e71828/Spur-gear-reducer/机械设计课程设计.pdf

## 机械设计课程设计 计算说明书

设计题目 | 带式输送机传动装置 4−E
班 | 级
学 | 号
姓 | 名
专 | 业 机械设计制造及其自动化

指导老师

完成日期 | 2018 年 07 月 06 日

目 录

1. 设计任务

传动简图如图 1 所示，设计参数列表列于表 1，工作条件：连续单向运

转，工作时有轻微振动，使用期 10 年，每年 300 个工作日，小批量生

产，两班制工作，输送机的工作轴转速允许误差为±5%，带式输送机的传

动效率为 0.96。

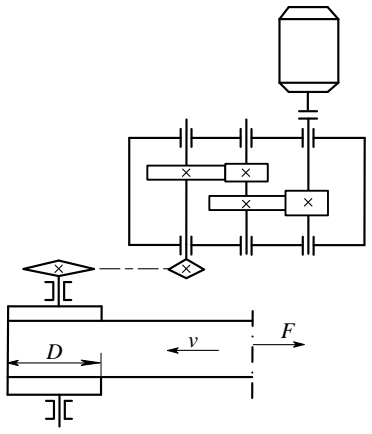
[picture p1: figure]

图 1 带式输送机传动简图

表 1 带式输送机的设计参数

题号 | 4−A | 4−B | 4−C | 4−D | 4−E
输送带的牵引力 F/kN | 2.8 | 2.9 | 3.0 | 3.2 | 3.6
输送带的速度 v/(m/s) | 0.9 | 0.85 | 1.0 | 0.95 | 0.75
输送带滚筒的直径 D/mm | 450 | 420 | 480 | 440 | 400

2. 传动方案拟定和分析

图 1 所给定的传动方案中利用了二级展开式齿轮减速器和链传动，我们

来分析它所具备的优点和缺点。

链传动和齿轮传动的效率都很高，结构紧凑，这两个的组合也保证了平

均传动比的恒定。齿轮传动利用了二级展开式齿轮减速箱，闭式传动，传动

比大，尺寸小，工作可靠，维护良好寿命可达到一二十年。直齿轮相比斜齿

轮，可以通过变位来提高强度和平稳性，或配凑中心距，成本比斜齿轮低；

直齿轮的理论上是没有轴向力的，可以采用深沟球轴承，有利于提高寿命和

维修与更换，设计起来也比较简单。

链传动的平均传动比不恒定，虽然链传动可以在恶劣环境中工作，但是

在工作中加重了振动和冲击。齿轮传动的最大要求就是安装精度，这又提升

了成本。斜齿轮的传动平稳性要优于直齿轮，而且同样配合链传动，斜齿轮

还能缓冲部分冲击，有利于提高寿命。

3. 传动系统动力参数计算

## 根据题目 4−E 要求，F=3.6kN，v=0.75m/s，D=400mm，结合传动方案，

选用深沟球轴承，每对轴承的效率 η=0.99，直齿轮采用 7 级精度，每对齿

轮副的效率 η=0.98，采用滚子链，滚子链的效率 η=0.96，联轴器由于需要

与电机直接连接，采用弹性套柱销联轴器，效率 η=0.99，已知输送带的效率

为 0.96。根据计算，所需要的电机功率为
( | ) ( | )
2
d = | × | ÷ | × | × | × | × | × | × | = 0.3 0.75 0.96 0.99 0.96 0.98 0.99 0.99 0.99 3.208 | | kW | P | ，

要求电动机提供的额定功率 Pm≥Pd，初步选用同步转速 1500 r/min 的三相异

步电机 Y112M−S，额定功率 4 kW，满载转速 1440 r/min，由于工作及转速
w n | vD = | × | × ÷× = 2 / | 1000 60 (2 ) 35.8 r/min π | ，可以算得传动系统的总传动比
为 | m | w in n = | = | = / | 1440 / 35.8 40.223，初选滚子链的传动比为 c

### i = 2.25，由于电

机轴到轴 I 的传动比为 1，则可以算得二级齿轮减速器的减速比为
g | c i ii = | = / | 40.223 / 2.25 17.8769 = | ，取高速级齿轮副传动比 1 | c i | i = | = 1.35 4.91，

由于各轴的转速和输入功率都能分别通过传动比和效率确定下来，

T | P | n | Pn = | π | ≈ 1000 / (2 / 60) 9549 / ，从而输入转矩也都可以确定下来，得表 2。

表 2 传动基本参数表

| 电动机轴 | 轴 I | 轴 II | 轴 III | 滚筒轴
功率 P/kW | 4 | 3.9204 | 3.8036 | 3.6902 | 3.5072
转速 n/(r/min) | 1440 | 1440 | 293.28 | 80.55 | 35.8
转矩 T/(N∙m) | 26.526 | 25.998 | 123.486 | 437.481 | 935.508
传动比 i | 1 | 4.91 | 3.64 | 2.25
效率 η | 0.9801 | 0.9702 | 0.9702 | 0.9504

4. 传动零件的设计

4.1 链传动的设计

计算项目及内容 | 主要结果
1. 选择链轮齿数

取小链轮齿数 z1=21，大链轮齿数 2 z =× = 21 2.25 47.25，
取 z2=47。
2. 确定计算功率

由参考文献[1]表 9-6，查得工况系数 KA=1.1，由图 9-

13，查得主动链轮齿数系数 Kz=1.22，采用双排链，多排链

系数 Kp=1.75，计算功率

ca | A | p
P K KP K = | =× | × | = z | / | 1.1 1.22 3.6902 /1.75 2.83 kN
3. 选择链条型号

## 由 Pca=2.83 kW，n1=293.8 r/min，和 Pca≤Pc，查图 9-11，

## 选择 16A-2，节距 p=25.4 mm。

4. 计算链节数和中心距

## 中心距 a0=(30~50)p=762~1270 mm，取 a0=1000 mm，

相应的链节数为

2
0 | 1 | 2 | 1 | 2
p0
0
2

2
2 | 2
2 1000 21 47 21 47 | 25.4 113.18
25.4 | 2 | 2 | 1000
+ | − | = | + | + | | π
× | + | − | = | + | + | × | = | | π
a zz | zz | p L
p | a

取 p0 L =114 (偶数)，查表 9-8，中心距计算系数

小链轮 z1=21，

大链轮 z2=47

## 链号 16A-2

1

0.24869 0.24809 114 21 0.24849 | 3.4 0.24866
3..6 3.4 | 47 21
− | − | = | + | × | − | = | − | − | f

则链传动的最大中心矩
( | )
( | )
max | 1 | p | 1 | 2 2
0.24866 25.4 2 114 21 47 | 1010.55 mm
= | − | + | |
= | × | ×× | − | + | = | |
a | fp L | z z
5. 计算链速 v，确定润滑方式
11 v nzp = | = | ×× | = / 60000 80.55 21 25.4 / 60000 0.72 m/s

## 由v = 0.72 m/s，链号 16A-2，查表 9-14，采用滴油润滑。

6. 计算水平布置时的压轴力 Fp
有效圆周力 e F | Pv = | = | × | = 1000 / 1000 3.6902 / 0.72 5152 N，

链轮水平布置时压轴力系数 KFp=1.15，则压轴力为

p | pe
F KF = | = | × | = F | 1.15 5125 5894 N
7. 选择链轮材料，计算尺寸

由表 9-5，选择 40 钢，并淬火、回火处理。

小链轮分度圆直径

1

1

25.4 | 170.421 mm
180 | 180
sin | sin
21
= | = | = | | | ° | °

p d

z

大链轮分度圆直径

2

2

25.4 | 380.281 mm
180 | 180
sin | sin
47
= | = | = | | | ° | °

p d

z

最大中心距
1011 mm

滴油润滑

压轴力

p

F = 5894 N

大链轮分度
圆 d2=380.281
mm

4.2 高速级齿轮副的设计

计算项目及内容 | 主要结果
1. 选择齿数类型、材料，初选齿轮齿数

直齿圆柱齿轮，压力角 α=20°，齿顶高系数 ha
*

=1，顶

隙系数 c*

=0.25，7 级精度，小齿轮采用 40Cr 合金（调质），

齿面硬度 280 HBS，大齿轮采用 45 钢（调质），齿面硬度

240 HBS，两个齿轮都是软齿面。

初选小齿轮齿数 z1=20，大齿轮 2 z =× = 20 4.91 98.2，取
z2=98。
2. 按齿面接触疲劳强度设计
(1) 小齿轮分度圆直径计算公式
3 | 2
Ht 1 | H E
1t
d | H
2 | 1 []
ε
φ | σ
+ | ≥ | ⋅ | ⋅ | |
KT u | ZZZ d
u
1) 确定公式中的各参数值

① 试选载荷系数 Ht K =1.5。

### ② 小齿轮传递的转矩 1 T = ⋅ 25998 N mm 。

③ 由表 10-7 试选宽径比 d φ =1。

④ 由图 10-20 查得区域系数 H Z = 2.5。

⑤ 由表 10-5 查得材料的弹性影响系数 | 1/2

## E Z =189.8 MPa 。

⑥ 计算接触疲劳强度用重合度系数Zε。

*

1 | 1 | 1 arccos[ cos / ( | 2 )]

### arccos[20 cos20 / (20 2 1)] 31.3213

α | α = | +
= | × | ° | +× = | °
a | a z | z | h

标准直齿轮

## 小齿轮 40Cr

大齿轮 45 钢

初选齿数
z1=20，z2=98

*
2 | 2 | 2
1 | 1 | 2 | 2

E

## arccos[ cos / ( 2 )] arccos[98 cos20 / (98 2 1)] 22.9422

[ (tan | tan ) | (tan | tan )] / (2 )

## [20 (tan31.3213 tan 20 ) 98 (tan 22.9422 tan 20 )] / (2 ) 1.7035

4 41
3

α

α

α | | α
ε | α | α | α | α

ε

= | | +
= | × | ° | +× = | °
= | − | + | − | π
= | × | °− | ° +
× | °− | ° | π =
− | − = | =
a | a
a | a
z | z | h
z | 'z | '
Z | .7035 0.8749
| 3 | =

⑦ 计算接触疲劳许用应力 H [] σ 。

由图 10-25d 查得小齿轮和大齿轮的接触疲劳强度极限

### 分别为 Hlim1 σ = 550 MPa ， Hlim2 σ = 600 MPa 。

计算应力循环次数：

9
1 | 1
9 | 8
2 | 1
60 | 60 1440 1 (2 8 300 10) 4.1472 10
/ | 4.1472 10 / 4.91 8.4464 10
= | = × | ×× × × | × | = | ×
= | = | × | = | ×
N | n jLh

### N Nu

由图 10-23，查得接触疲劳寿命系数 H 1
= 0.90 K N 、

H 2

= 0.95 K N 。

取失效概率为 1%，安全系数为 S=1，得

1

2

H Hlim1
H 1

H Hlim2
H2
0.90 550 [ ] | 495 MPa
1
0.95 600 [ ] | 570 MPa
1

σ
σ
σ
σ
× = | = | =
× = | = | =

N

N

K
S
K
S
取 H 1 [] σ 和 H2 [] σ 中的较小者作为该齿轮副的接触疲劳许用应
力，即[ ] min [ ] ,[ ] | 495 MPa σ | σσ H = | { H1 | H2} = | 。
2) 试算小齿轮分度圆直径
3 | | | | 2
Ht 1 | H E
1t
d | H
3 | 2
2 | 1
[]
2 1.5 25998 4.91 1 2.5 189.8 0.8749 1 | 4.91 | 495

ε
φ | σ
+ | ≥ | ⋅ | ⋅ | |
×× | + | × | × | = | × | × | |
KT u | ZZZ d
u

重合度
εα=1.7035

接触疲劳许用

应力

## [σH]=495MPa

=40.4187 mm
(2) 调整小齿轮分度圆直径
1) 计算实际载荷系数前的数据准备

① 圆周速度 v。
1t 1 v | dn =π | =π× | × / 60000 | 40.4187 1440 / 60000 3.05 m/s =

② 齿宽 b。
d 1t b | d = | =× | = φ | 1 40.4187 40.4187 mm
2) 计算实际载荷系数KH

① 由表 10-2，查得使用系数 A K =1.25。

② 根据v = 3.05 m/s，7 级精度，由图 10-8，查得动载系数
v K =1.12。

③ 齿轮的圆周力。
t1 | 1 | 1t F | Td = | = 2 / | 2 25998 / 40.4187 1286 N × | =
A t1 KF b/ | 1.25 1286 / 40.4187 39.8 N/mm<100 N/mm = | × | =
查表 10-3 得齿间载荷分配系数 H | 1.2 K α = | 。

④ 由表 10-4 用插值法查得 7 级精度、小齿轮相对支撑非对

称布置时，齿向载荷分布系数 H | 1.417 K β = | 。

由此可以得到实际载荷系数系数
H | A | vH | H | 1.25 1.12 1.2 1.417 2.3806 K KKK K = | = | × | ×× | = α | β
3) 按实际载荷系数算得的分度圆直径
3 | 3
H
1 1t
Ht
2.3806 40.4187 | 47.146 mm
1.5
= | = | × | =

## K dd

K

及相应的齿轮模数

试算直径

## d1=40.419 mm

调整后的直径

## d1=47.146 mm

对应模数

## m=2.357 mm

1 | 1 mdz = | = | = / | 47.146 / 20 2.357 mm
3. 按齿根弯曲疲劳强度设计
(1) 模数计算公式

3
Ft 1 | Fa sa
t | 2
d1 | F

2
[]

ε
φ | σ
- | ≥ | ⋅ | |

### K TY Y Y

m
z
1) 确定公式中的各参数值

### ① 试选KFt =1.5。

② 计算弯曲疲劳强度用重合度系数。
0.75 | 0.75 0.25 | 0.25 | 0.6903
1.7035 ε
α ε
Y = | + | = | + | =

③ 计算 Fa sa
F [] σ

YY 。

由图 10-17 查得齿形系数 Fa1 Y = 2.82、 Fa 2 Y = 2.19。

由图 10-18 查得应力修正系数 sa1 Y =1.55、 sa 2 Y =1.81。

由图 10-24 查得小齿轮和大齿轮的弯曲疲劳强度极限分别

### 为σ Flim1 = 500 MPa 、 Flim2 σ = 380 MPa。

由图 10-22 查得弯曲疲劳寿命系数 F 1
K N = 0.85 、

F 2

K N = 0.88。

取弯曲疲劳安全系数 S=1.4，得

1

2

F Flim1
F1

F Flim2
F2
0.85 500 [ ] | 303.57 MPa
1.4
0.88 380 [ ] | 238.86 MPa
1.4

σ
σ
σ
σ
× = | = | =
× = | = | =

N

N

K
S
K
S

弯曲疲劳许用

应力

## [σF]1=303 MPa

## [σF]2=238 MPa

Fa1 sa1

F1

Fa 2 sa 2

F2

2.82 1.55 0.0144
[ ] | 303.57
| 2.19 1.81 0.0166
[ ] | 238.86

σ

σ

× = | =
× = | =

Y Y

YY

因为大齿轮的 Fa sa
F [] σ

YY 大于小齿轮，所以取

Fa sa | Fa 2 sa 2
F | F2

0.0166

[] [] σ | σ = | = YY Y Y
2) 试算齿轮模数

3
Ft 1 | Fa sa
t | 2
d1 | F
3

2

2
[]
2 1.5 25998 0.6903
= | 0.0166
1 20
=1.3073 mm

ε
φ | σ
- | ≥ | ⋅ | |
×× | ×
×
×

### K TY Y Y

m
z
(2) 调整齿轮模数
1) 计算实际载荷系数前的数据准备

① 圆周速度 v。
1 | t1 d mz = | = | ×= 1.3073 20 26.146 mm
11 v | dn =π | =π× | × / 60000 | 26.146 1440 / 60000 1.97 m/s =

② 齿宽 b。
d1 b | d = | =× | = φ | 1 26.146 26.146 mm

③ 宽高比 b/h。
( | ) * | *
a | t h | h cm = | + | = ×+ | × | = (2 | ) | 2 1 0.25 1.3072 3.0831 mm
b h/ | 26.146 / 3.0831 8.48 = | =
2) 计算实际载荷系数

试算模数

## m=1.3073 mm

① 根据v =1.97 m/s，7 级精度，由图 10-8，查得动载系数
Kv =1.078。

② 齿轮的圆周力。
t1 | 1 | 1t F | Td = | = 2 / | 2 25998 / 26.146 1989 N × | =
A t1 KF b/ | 1.25 1989 / 26.146 95 N/mm<100 N/mm = | × | =
③ 查表 10-3 得齿间载荷分配系数 F | 1.2 K α = | 。
④ 由表 10-4 用插值法查得 H | 1.417 K β = | ，结合b h/ | 8.48 = | ，
查图 10-13，得 F | 1.35 K β = | 。

则实际载荷系数
F | A | vF | F | 1.25 1.078 1.2 1.35 2.1830 K KKK K = | = | × | ×× | = α | β
3) 按实际载荷系数算得的模数

3 3
F
t
Ft
2.1830 1.3073 | 1.4815 mm
1.5
= | = | × | =

K
m m
K

对比计算结果，由齿面接触疲劳强度计算的模数 m 大

于由齿根弯曲疲劳极限计算的模数，由于齿轮模数的大小

主要取决于弯曲疲劳强度所决定的承载能力，而齿面接触

疲劳强度所决定的承载能力，仅与齿轮直径有关，可取由弯

曲疲劳强度算的的模数 1.4815 mm，但考虑到动力传动的可

靠性，一般模数不小于 2 mm，所以就近取标准值 m=2 mm，

按接触疲劳强度算的分度圆直径d1 = 47.146 mm，算得小齿
轮齿数 1 | 1 z dm = | = | = / | 47.146 / 2 23.573。

调整后的模数

## m=1.4815 mm

小于最小可靠

传动标准 m=2
mm

故取模数为

## m=2 mm

取 1z = 24，则大齿轮齿数 2 | 1 z uz = | = | ×= 4.91 24 117.84，取

2 z =119， 1z 与 2 z 互为质数。这样设计出的齿轮既满足齿面

接触疲劳强度，又满足了齿根弯曲疲劳强度，并做到结构紧

凑，磨损均匀，避免浪费。

4. 几何尺寸计算
(1) 计算分度圆直径
1 | 1
2 | 2

2 24 48 mm
2 119 238 mm
= | =× =
= | =× | =

### d mz d mz

(2) 计算中心距
1 | 2 add = | + | = | + | = ( | ) / 2 (48 238) / 2 143 mm
(3) 计算齿轮宽度
d1 b | d = | =× = φ | 1 48 48 mm

考虑不可避免的安装误差，为了保证设计齿宽和节省

材料，一般将小齿轮略加宽(5~10) mm，即
1 bb =+ | = + | = (5 ~ 10) 48 (5 ~ 10) 53 ~ 58 mm

取 1 b = 55 mm ，而使大齿轮的齿宽等于设计齿宽，即

### 2 bb = = 48 mm 。

5. 圆整中心距后的强度校核

上述齿轮副的中心距不便于相关零件的设计和制造。

为此，可以通过调整传动比、改变齿数或变位法来进行圆

整。本设计采用变位法将中心距就近圆整至a' =145 mm，以

变位系数和不超过图 10-21a 推荐的合理工作范围为宜。其

它几何参数，如 z1、z2、m、α、b 等保持不变。

z1=24，z2=119

中心距

## a=143 mm

小齿轮齿宽

## b1=55 mm

大齿轮齿宽

## b2=48 mm

圆整中心距

## a' =145 mm

(1) 计算变位系数和
1) 计算啮合角、齿数和、变位系数和、中心距变动系数，

齿顶高降低系数。

1 | 2
1 | 2

## arccos[( cos ) / ] arccos[(143 cos20 ) /145] 22.0691

24 119 143

## (inv inv ) / (2tan ) =(inv22.0691 inv20 ) 143 / (2tan 20 ) 1.050

α | α
α | α | α

∑

∑ | ∑

=
= | × | ° | = | °
=+ = + | =
=+ = | −
°− | ° × | ° =
' | a | a'

### z zz

x xx | ' | z
( | ) / | (145 143) / 2 1
1.050 1 0.050 ∑
= | − | = | − | =
∆= − = | −=
y | a' a m

### yx y

从图 10-21a 知，当前的变位系数提高了齿轮强度，但

重合度有所降低。

2) 分配变位系数
由图 10-21b 可知，坐标点( / 2, / 2) (71.5,0.525) z | x ∑ | ∑ | = | 位

于 L14 线与 L15 线之间，按这两条线作射线，再从横坐标

的 z1、z2处作垂直线，与射线交点的纵坐标分别为 1 x = 0.52、

2 x = 0.53。

(2) 齿面接触疲劳强度校核
1) 校核公式

H1
H | 3 | HE
| d1
2 | 1
σ | ε φ
+ = | ⋅ | ⋅ KT u | ZZZ
d | u
2) 数据准备

① 圆周速度 v。
11 v | dn =π | =π× × / 60000 | 48 1440 / 60000 3.62 m/s =

② 接触齿宽b = 48 mm 。

啮合角
α' = ° 22.0691

变位系数和+

正传动

变位系数
1 x = 0.52
2 x = 0.53

## ③ 传动比u = = 119 / 24 4.9583。

3) 计算实际载荷系数KH

① 根据v = 3.62 m/s，7 级精度，由图 10-8，查得动载系数
v K =1.14。

② 齿轮的圆周力（用分度圆估算）。
t1 | 1 | 1 F | Td = | =× | = 2 / | 2 25998 / 48 1083 N
A t1 KF b/ | 1.25 1083 / 48 28 N/mm<100 N/mm = | × | =
查表 10-3 得齿间载荷分配系数 H | 1.2 K α = | 。

③ 由表 10-4 用插值法查得 7 级精度、小齿轮相对支撑非对

称布置时，齿向载荷分布系数

H

1.426 1.417 1.417 | (48 40) 1.4188 80 40 β
− = | + | × | − | = − K

由此可以得到实际载荷系数系数
H | A | vH | H | 1.25 1.14 1.2 1.4188 2.4261 K KKK K = | = | × | ×× | = α | β
4) 计算区域系数ZH。
H | 2 | 2
2cos | 2 cos22.0691 | 2.3636
cos sin | cos 20 sin 22.0691

α
αα
× | ° = | = | = °× | °
' Z | '
5) 计算接触疲劳强度用重合度系数Zε。

*
1 | 1 | 1 | 1

*
2 | 2 | 2 | 2
1 | 1
arccos[ cos / ( | 2 | )]

## arccos[24 cos20 / (24 2 1 0.52 0.05)]

33.1604
arccos[ cos / ( | 2 | )]

## arccos[119 cos20 / (119 2 1 0.53 0.05)]

23.5250
[ (tan | tan α
α | α
α | α
ε | α
= | | + | + −∆
= | × | ° | + ×+ | −
= | °
= | | + | + −∆
= | × | ° | + ×+ | −
= | °
= | −
a | a
a | a

a

z | z | hx | y
z | z | hx | y
z | 2 | 2 ) | (tan | tan )] / (2 )

## [20 (tan33.1604 tan 22.0691 )

α | α | α + | − | π
= | × | °− | ° +
a 'z | '

节圆
1 d' = 45.6173
2 d' = 241.3287

齿顶圆
1 = 53.880 a d'
2 = 243.920 a d'

齿根圆
f1 d = 45.080
f2 d = 235.120

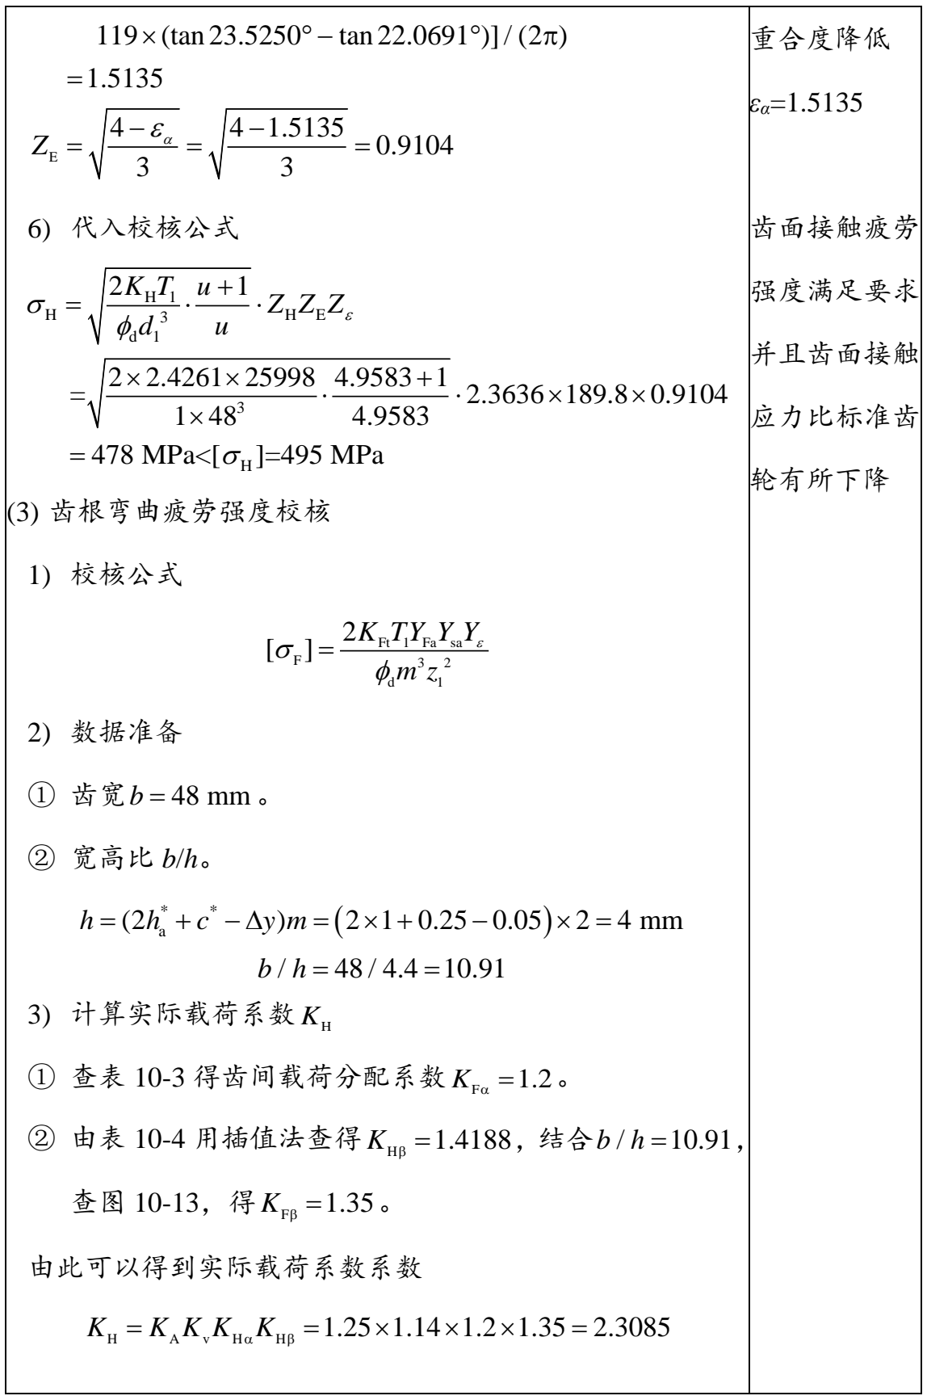
[picture p2: figure]
119 (tan 23.5250 tan 22.0691 )] / (2 ) 1.5135; 6) 代入校核公式; 478 MPa<[ ]=495 MPa; ZZZ; (3) 齿根弯曲疲劳强度校核; 1) 校核公式; 2) 数据准备; ① 齿宽b = 48 mm 。; ② 宽高比 b/h。; 3) 计算实际载荷系数KH; ① 查表 10-3 得齿间载荷分配系数 F; 由此可以得到实际载荷系数系数; 重合度降低; 齿面接触疲劳; 强度满足要求; 并且齿面接触; 应力比标准齿; 轮有所下降

a h | h c | ym = | + −∆ | = × + | − | × = (2 | ) | 2 1 0.25 0.05 2 4 mm
② 由表 10-4 用插值法查得 H | 1.4188 K β = | ，结合b h/ 10.91 = | ，
H | A | vH | H | 1.25 1.14 1.2 1.35 2.3085 K KKK K = | = | × | ×× | = α | β

4) 弯曲疲劳强度用重合度系数 | 0.75 0.25 | 0.7455
1.5135
Yε = | + | = | 。
5) 由图 10-17 查得齿形系数 Fa1 Y = 2.16、 Fa 2 Y = 2.07。
6) 由图 10-18 查得应力修正系数 sa1 Y =1.825、 sa 2 Y =1.93。
7) 代入校核公式

Ft 1 Fa1 sa1
F1 | 32
d | 1
3 | 2

F1

Ft 1 Fa 2 sa 2
F2 | 32
d | 1
3 | 2

2

2 2.3085 25998 2.16 1.825 0.7455 1 2 24

## 76.55 MPa<[ ] 303.57 MPa

2

2 2.3085 25998 2.07 1.93 0.7455 1 2 24

## 77.58 MPa

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
× | × | × | × | × = | ××
= | =

=

× | × | × | × | × = | ××

=

### K TY Y Y

mz

### K TY Y Y

mz

## <[ ] 238.86 MPa σ F2 =

齿根弯曲强度

满足要求，并

且小齿轮的抵

抗弯曲疲劳破

坏的能力大于

大齿轮。

4.3 低速级齿轮副的设计

计算项目及内容 | 主要结果
1. 选择齿数类型、材料，初选齿轮齿数

直齿圆柱齿轮，压力角 α=20°，齿顶高系数 ha
*

=1，顶

隙系数 c*

=0.25，7 级精度，小齿轮采用 40Cr 合金（调质），

齿面硬度 280 HBS，大齿轮采用 45 钢（调质），齿面硬度

240 HBS，两个齿轮都是软齿面。

初选小齿轮齿数 z1=20，大齿轮 2 z =× = 20 3.64 72.8，取
z2=73。
2. 按齿面接触疲劳强度设计
(1) 小齿轮分度圆直径计算公式
3 | 2
Ht 1 | H E
1t
d | H
2 | 1 []
ε
φ | σ
+ | ≥ | ⋅ | ⋅ | |
KT u | ZZZ d
u
1) 确定公式中的各参数值

① 试选载荷系数 Ht K =1.5。
② 小齿轮传递的转矩 1 T = | ⋅ 123846 N mm。

③ 由表 10-7 试选宽径比 d φ =1。

④ 由图 10-20 查得区域系数 H Z = 2.5。

⑤ 由表 10-5 查得材料的弹性影响系数 | 1/2

## E Z =189.8 MPa 。

⑥ 计算接触疲劳强度用重合度系数Zε。

*

1 | 1 | 1 arccos[ cos / ( | 2 )]

### arccos[20 cos20 / (20 2 1)] 31.3213

α | α = | +
= | × | ° | +× = | °
a | a z | z | h

标准直齿轮

## 小齿轮 40Cr

大齿轮 45 钢

初选齿数
z1=20，z2=73

*
2 | 2 | 2
1 | 1 | 2 | 2

E

## arccos[ cos / ( 2 )] arccos[73 cos20 / (73 2 1)] 23.8462

[ (tan | tan ) | (tan | tan )] / (2 )

## [20 (tan31.3213 tan 20 ) 73 (tan 23.8462 tan 20 )] / (2 ) 1.6852

4 41
3

α

α

α | | α
ε | α | α | α | α

ε

= | | +
= | × | ° | +× = | °
= | − | + | − | π
= | × | °− | ° +
× | °− | ° | π =
− | − = | =
a | a
a | a
z | z | h
z | 'z | '
Z | .6852 0.8784
| 3 | =

⑦ 计算接触疲劳许用应力 H [] σ 。

由图 10-25d 查得小齿轮和大齿轮的接触疲劳强度极限

### 分别为 Hlim1 σ = 550 MPa ， Hlim2 σ = 600 MPa 。

计算应力循环次数：

8
1 | 1
8 | 8
2 | 1
60 | 60 293.28 1 (2 8 300 10) 8.4464 10
/ | 8.4464 10 / 3.64 2.3204 10
= | = × | ×× × × | × | = | ×
= | = | × | = | ×
N | n jLh

### N Nu

由图 10-23，查得接触疲劳寿命系数 H 1
= 0.90 K N 、

H 2

= 0.95 K N 。

取失效概率为 1%，安全系数为 S=1，得

1

2

H Hlim1
H 1

H Hlim2
H2
0.90 550 [ ] | 495 MPa
1
0.95 600 [ ] | 570 MPa
1

σ
σ
σ
σ
× = | = | =
× = | = | =

N

N

K
S
K
S
取 H 1 [] σ 和 H2 [] σ 中的较小者作为该齿轮副的接触疲劳许用应
力，即[ ] min [ ] ,[ ] | 495 MPa σ | σσ H = | { H1 | H2} = | 。
2) 试算小齿轮分度圆直径
3 | | | | 2
Ht 1 | H E
1t
d | H
3 | 2
2 | 1
[]
2 1.5 123846 3.64 1 2.5 189.8 0.8784 1 | 3.64 | 495

ε
φ | σ
+ | ≥ | ⋅ | ⋅ | |
×× | + | × | × | = | × | × | |
KT u | ZZZ d
u

重合度
εα=1.6852

接触疲劳许用

应力

## [σH]=495MPa

试算直径

## d1=69.506 mm

=69.5060 mm
(2) 调整小齿轮分度圆直径
1) 计算实际载荷系数前的数据准备

① 圆周速度 v。
1t 1 v | dn =π | =π× | × / 60000 | 69.5060 293.28 / 60000 1.07 m/s =

② 齿宽 b。
d 1t b | d = | =× | = φ | 1 69.5060 69.5060 mm
2) 计算实际载荷系数KH

① 由表 10-2，查得使用系数 A K =1.25。

② 根据v =1.07 m/s，7 级精度，由图 10-8，查得动载系数
v K =1.043。

③ 齿轮的圆周力。
t1 | 1 | 1t F | Td = | = 2 / | 2 123846 / 69.5060 3564 N × | =
A t1 KF b/ | 1.25 3564 / 69.5060 64 N/mm<100 N/mm = | × | =
查表 10-3 得齿间载荷分配系数 H | 1.2 K α = | 。

④ 由表 10-4 用插值法查得 7 级精度、小齿轮相对支撑非对

称布置时，齿向载荷分布系数

H

1.426 1.417 1.417 | (69.5060 40) 1.4216 80 40 β
− = | + | × | − | = − K

由此可以得到实际载荷系数系数
H | A | vH | H | 1.25 1.043 1.2 1.4216 2.2241 K KKK K = | = | × | ×× | = α | β
3) 按实际载荷系数算得的分度圆直径
3 | 3
H
1 1t
Ht
2.2241 69.5060 | 79.258 mm
1.5
= | = | × | =

## K dd

K

调整后的直径

## d1=79.258 mm

对应模数

## m=3.963 mm

及相应的齿轮模数
1 | 1 mdz = | = | = / | 79.258 / 20 3.963 mm
3. 按齿根弯曲疲劳强度设计
(1) 模数计算公式

3
Ft 1 | Fa sa
t | 2
d1 | F

2
[]

ε
φ | σ
- | ≥ | ⋅ | |

### K TY Y Y

m
z
1) 确定公式中的各参数值

### ① 试选KFt =1.5。

② 计算弯曲疲劳强度用重合度系数。
0.75 | 0.75 0.25 | 0.25 | 0.6951
1.6852 ε
α ε
Y = | + | = | + | =

③ 计算 Fa sa
F [] σ

YY 。

由图 10-17 查得齿形系数 Fa1 Y = 2.82、 Fa 2 Y = 2.30。

由图 10-18 查得应力修正系数 sa1 Y =1.55、 sa 2 Y =1.76。

由图 10-24 查得小齿轮和大齿轮的弯曲疲劳强度极限分别

### 为σ Flim1 = 500 MPa 、 Flim2 σ = 380 MPa。

由图 10-22 查得弯曲疲劳寿命系数 F 1
K N = 0.85 、

F 2

K N = 0.88。

取弯曲疲劳安全系数 S=1.4，得

1

2

F Flim1
F1

F Flim2
F2
0.85 500 [ ] | 303.57 MPa
1.4
0.88 380 [ ] | 238.86 MPa
1.4

σ
σ
σ
σ
× = | = | =
× = | = | =

N

N

K
S
K
S

弯曲疲劳许用

应力

## [σF]1=303MPa

## [σF]2=238MPa

Fa1 sa1

F1

Fa 2 sa 2

F2

2.82 1.55 0.0144
[ ] | 303.57
| 2.30 1.76 0.0169
[ ] | 238.86

σ

σ

× = | =
× = | =

Y Y

YY

因为大齿轮的 Fa sa
F [] σ

YY 大于小齿轮，所以取

Fa sa | Fa 2 sa 2
F | F2

0.0169

[] [] σ | σ = | = YY Y Y
2) 试算齿轮模数

3
Ft 1 | Fa sa
t | 2
d1 | F
3

2

2
[]
2 1.5 123846 0.6951
= | 0.0169
1 20
=2.2180 mm

ε
φ | σ
- | ≥ | ⋅ | |
×× | ×
×
×

### K TY Y Y

m
z
(2) 调整齿轮模数
1) 计算实际载荷系数前的数据准备

① 圆周速度 v。
1 | t1 d mz = | = | ×= 2.2180 20 44.360 mm
11 v | dn =π | =π× | × / 60000 | 44.36 293.28 / 60000 0.68 m/s =

② 齿宽 b。
d1 b | d = | =× | = φ | 1 44.36 44.36 mm

③ 宽高比 b/h。
( | ) * | *
a | t h | h cm = | + | = ×+ | × | = (2 | ) | 2 1 0.25 2.2180 4.9905 mm
b h/ | 44.36 / 4.9905 8.89 = | =
2) 计算实际载荷系数

试算模数

## m=2.2180 mm

① 根据v = 0.68 m/s ，7 级精度，由图 10-8，查得动载系

### 数K =1.027 。 v

② 齿轮的圆周力。

t1 | 1 | 1 F | Td = | = 2 / | 2 123846 / 44.36 5584 N × | =
A t1 KF b/ | 1.25 5584 / 44.36 157 N/mm>100 N/mm = | × | =
③ 查表 10-3 得齿间载荷分配系数 F | 1.0 K α = | 。
④ 由表 10-4 用插值法查得 H | 1.4216 K β = | ，结合b h/ | 8.89 = | ，
查图 10-13，得 F | 1.37 K β = | 。

则实际载荷系数
F | AvF | F | 1.25 1.027 1.0 1.37 1.7587 K KKK K = | = | × | ×× | = α | β
3) 按实际载荷系数算得的模数

3 3
F
t
Ft
1.7587 2.2180 | 2.339 mm
1.5
= | = | × | =

K
m m
K

对比计算结果，由齿面接触疲劳强度计算的模数 m 大

于由齿根弯曲疲劳极限计算的模数，由于齿轮模数的大小

主要取决于弯曲疲劳强度所决定的承载能力，而齿面接触

疲劳强度所决定的承载能力，仅与齿轮直径有关，可取由弯

曲疲劳强度算的的模数 2.339 mm，就近取标准值 m=2.5

mm，按接触疲劳强度算的分度圆直径d1 = 79.258 mm，算得

小齿轮齿数 1 | 1 z dm = | = / | 79.258 / 2.5 31.7 = | 。
取 1z = 32，则大齿轮齿数 2 | 1 z uz = | = | ×= 3.64 32 116.48，取

2 z =117， 1z 与 2 z 互为质数。这样设计出的齿轮既满足齿面

调整后的模数

## m=2.339 mm

大于最小可靠

传动标准 m=2
mm

故取模数为

## m=2.5 mm

z1=32，z2=117

接触疲劳强度，由满足了齿根弯曲疲劳强度，并做到结构紧

凑，磨损均匀，避免浪费。

4. 几何尺寸计算
(1) 计算分度圆直径
1 | 1
2 | 2

2.5 32 80 mm
2.5 117 292.5 mm
= | = | ×=
= | = | × | =

### d mz d mz

(2) 计算中心距
1 | 2 add = | + | = | + | = ( | ) / 2 (80 292.5) / 2 186.25 mm
(3) 计算齿轮宽度
d1 b | d = | =× = φ | 1 80 80 mm

考虑不可避免的安装误差，为了保证设计齿宽和节省

材料，一般将小齿轮略加宽(5~10) mm，即
1 bb =+ | = + | = (5 ~ 10) 80 (5 ~ 10) 85 ~ 90 mm

取 1 b = 85 mm ，而使大齿轮的齿宽等于设计齿宽，即

### 2 bb = = 80 mm。

5. 圆整中心距后的强度校核

上述齿轮副的中心距不便于相关零件的设计和制造。

为此，可以通过调整传动比、改变齿数或变位法来进行圆

整。本设计采用变位法将中心距就近圆整至a' =185 mm，以

变位系数和不超过图 10-21a 推荐的合理工作范围为宜。其

它几何参数，如 z1、z2、m、α、b 等保持不变。

(1) 计算变位系数

中心距

## a=186.25 mm

小齿轮齿宽

## b1=85 mm

大齿轮齿宽

## b2=80 mm

圆整中心距

## a' =185 mm

1) 计算啮合角、齿数和、变位系数和、中心距变动系数，

齿顶高降低系数。

1 | 2
1 | 2

## arccos[( cos ) / ] arccos[(186.25 cos20 ) /145] 18.9077

32 117 149

## (inv inv ) / (2tan ) =(inv18.9077 inv20 ) 149 / (2tan 20 ) 0.4870

α | α
α | α | α

∑

∑ | ∑

=
= | × | ° | = | °
=+ = + | =
=+ = | −
| °− | ° × | | ° = −
' | a | a'

### z zz

x xx | ' | z
( | ) / | (185 186.25) / 2.5 0.5
0.487 ( 0.5) 0.013 ∑
= | − | = | − | =−
∆ = − =− | − − | =
y | a' a m

### yx y

从图 10-21a 知，当前的变位系数提高了重合度，但齿

轮强度有所降低。

2) 分配变位系数
由图 10-21b 可知，坐标点( / 2, / 2) (74.5, 0.2435) z | x ∑ | ∑ | = | −

位于 L9 线与 L10 线之间，按这两条线作射线，再从横坐标

的 z1、z2处作垂直线，与射线交点的纵坐标分别为 1 x = 0.1、

2 x = −0.587。

(2) 齿面接触疲劳强度校核
1) 校核公式

H1
H | 3 | HE
| d1
2 | 1
σ | ε φ
+ = | ⋅ | ⋅ KT u | ZZZ
d | u
2) 数据准备

① 圆周速度 v。
11 v | dn =π | =π× × / 60000 | 80 293.28 / 60000 1.23 m/s =

② 接触齿宽b = 80 mm。

## ③ 传动比u = = 117 / 32 3.65625。

啮合角
α' = ° 18.9077

变位系数和-

负传动

变位系数
1 x = 0.1
2 x = −0.587

节圆
1 d' = 79.4631
2 d' = 241.3287

齿顶圆
1 = 85.435 a d'
2 = 294.500 a d'

齿根圆
f1 d = 74.250
f2 d = 283.315

3) 计算实际载荷系数KH

① 根据v =1.23 m/s，7 级精度，由图 10-8，查得动载系

### 数K =1.049 。 v

② 齿轮的圆周力（用分度圆估算）。

t1 | 1 | 1 F | Td = | =× | = 2 / | 2 123846 / 80 3096 N
A t1 KF b/ | 1.25 3096 / 80 48 N/mm<100 N/mm = | × | =
查表 10-3 得齿间载荷分配系数 H | 1.2 K α = | 。

③ 由表 10-4 用插值法查得 7 级精度、小齿轮相对支撑非对

称布置时，齿向载荷分布系数 H | 1.426 K β = | 。

由此可以得到实际载荷系数系数
H | AvH | H | 1.25 1.049 1.2 1.426 2.2438 K KKK K = | = | × | ×× | = α | β
4) 计算区域系数ZH。
H | 2 | 2
2cos | 2 cos18.9077 | 2.5715
cos sin | cos 20 sin18.9077

α
αα
× | ° = | = | = °× | °
' Z | '
5) 计算接触疲劳强度用重合度系数Zε。

*
1 | 1 | 1 | 1

*
2 | 2 | 2 | 2
1 | 1
arccos[ cos / ( | 2 | ]

## arccos[32 cos20 / (32 2 1 0.1 0.013)]

28.3681
arccos[ cos / ( | 2 | )]

## arccos[117 cos20 / (117 2 1 0.587 0.013)]

21.0430
[ (tan | ta α
α | α
α | α
ε | α
= | | + | + −∆
= | × | ° | + ×+ | −
= | °
= | | + | + −∆
= | × | ° | + ×− | −
= | °
= | −
a | a
a | a

a

z | z | hx | y
z | z | hx | y
z | 2 | 2 n ) | (tan | tan )] / (2 )

## [32 (tan 28.3681 tan18.9077 ) 117 (tan 21.0430 tan18.9077 )] / (2 )

1.7914

α | α | α + | − | π
= | × | °− | ° +
× | °− | ° | π
=
a 'z | '
重合度提高
εα=1.7914

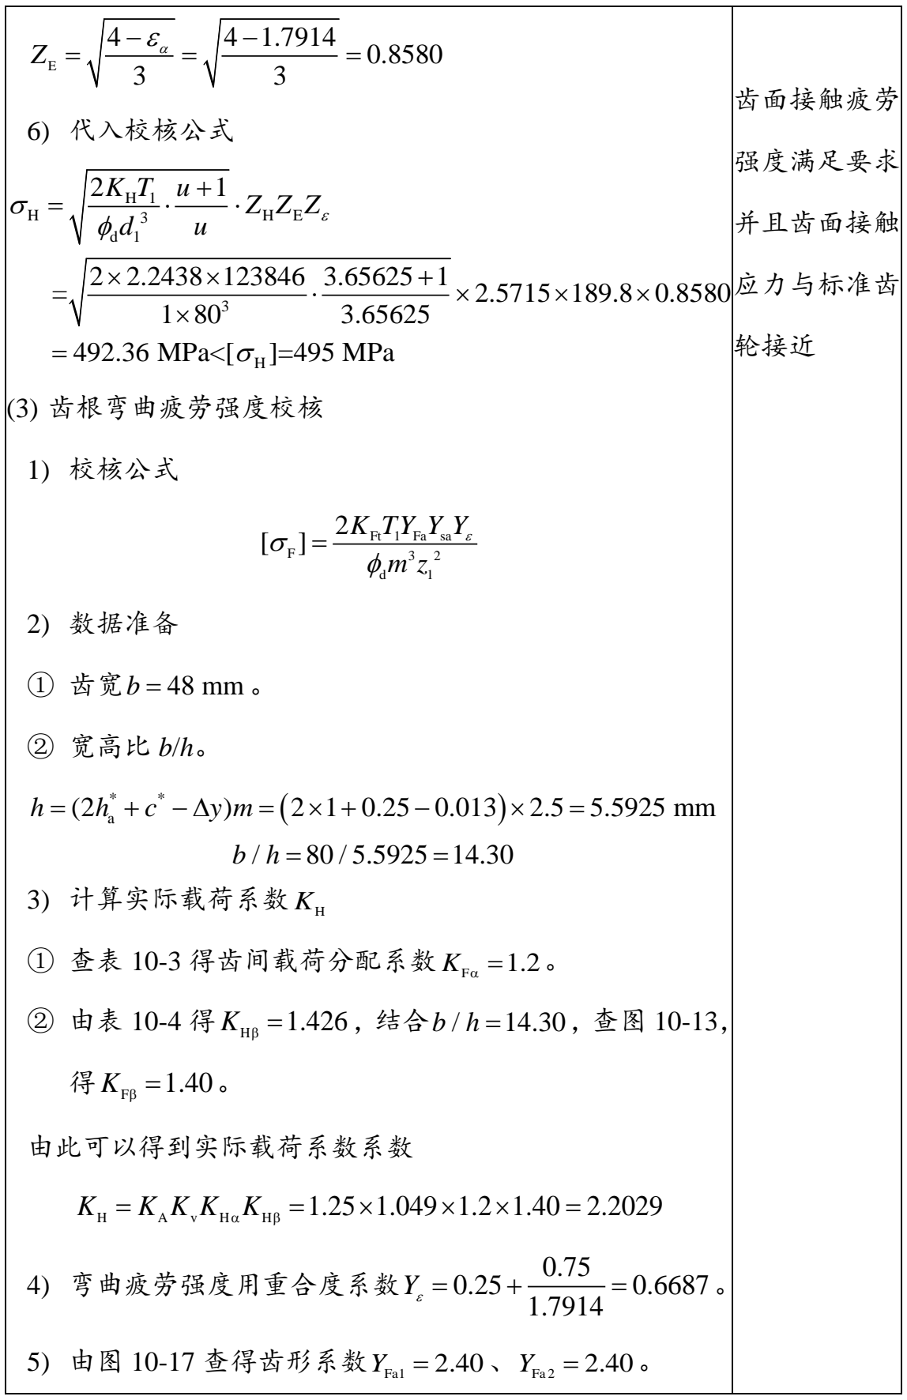
[picture p3: figure]
6) 代入校核公式; 492.36 MPa<[ ]=495 MPa; ZZZ; (3) 齿根弯曲疲劳强度校核; 1) 校核公式; 2) 数据准备; ① 齿宽b = 48 mm 。; ② 宽高比 b/h。; 3) 计算实际载荷系数KH; ① 查表 10-3 得齿间载荷分配系数 F; 由此可以得到实际载荷系数系数; 4) 弯曲疲劳强度用重合度系数; 齿面接触疲劳; 强度满足要求; 并且齿面接触; 应力与标准齿; 轮接近

a h | h c | ym = | + −∆ | = × + | − | × | = (2 | ) | 2 1 0.25 0.013 2.5 5.5925 mm
② 由表 10-4 得 H | 1.426 K β = | ，结合b h/ 14.30 = | ，查图 10-13，
H | AvH | H | 1.25 1.049 1.2 1.40 2.2029 K KKK K = | = | × | ×× | = α | β
5) 由图 10-17 查得齿形系数YFa1 = 2.40、YFa 2 = 2.40。

6) 由图 10-18 查得应力修正系数 sa1 Y =1.70、 sa 2 Y =1.63。
7) 代入校核公式

Ft 1 Fa1 sa1
F1 | 32
d | 1
3 | 2

F1

Ft 1 Fa 2 sa 2
F2 | 32
d | 1
3 | 2

2

2 2.2029 123846 2.40 1.7 0.6687 1 2.5 32

## 93 MPa<[ ] 303.57 MPa

2

2 2.2029 123846 2.40 1.63 0.6687 1 2.5 32

## 89 MPa<[

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
× | × | × | ×× = | × | ×
= | =

=

× | × | × | × | × = | × | ×

=

### K TY Y Y

mz

### K TY Y Y

mz

## F2 σ ] 238.86 MPa =

齿根弯曲强度

满足要求，并

且小齿轮的抵

抗弯曲疲劳破

坏的能力大于

大齿轮。

5. 轴的设计计算
计算项目及内容 | 主要结果

轴 I

由于轴 I 直接与电动机通过联轴器相连，而预选了弹性

套柱销联轴器，考虑到电机轴的直径 D=28 mm，采用 LT4

型号的弹性套柱销联轴器，又综合小齿轮的尺寸，轴 I 的连

接端直径设计为 20 mm，材料选择 45 钢，调质处理。

联轴器的计算转矩T KT ca | A 3 = | ，查表 14-1，考虑转矩变

化很小，轻微振动，故取 A K =1.5，则
ca | A 3 T KT = | = | × | = | ⋅ | ⋅ 1.5 25.998 38.997 N m<63 N m

按照计算转矩应该小于联轴器的公称转矩，查[2]表 17-

4 得 LT4 型号的公称转矩为 63 N∙m，符合条件，许用转速

也符合要求。选择，半联轴器与轴配合的毂孔长度 L1=38
mm。
1. 求作用在直齿轮上的力

高速级小齿轮的节圆直径为 1 d' = 45.6173，则

t1
1

r1 t1

t1
n

2 2 25998 1068 N
48.6713

## tan 1068 tan 20 388.7 N

1068 1137 N

## cos cos20

α

α

× = | = | =
= | = | × | °=
= | = | =°

T F
d'
FF
F F

圆周力，径向力的方向在后面的弯扭校核分析中标出。

2. 按扭转强度条件校核最小直径

LT4 弹性套柱

销联轴器

J1 型轴孔、A

型键槽

名义法向力

## Fn=1137 N

轴的扭转强度条件为

3 | [] 0.2
τ | τ T | T = | ≈ | ≤

T

T | T
W | d

式中：τ T ——扭转切应力，MPa；

T ——轴所受的扭矩，N∙mm；

WT ——轴的抗扭截面系数，mm³
；

d——计算截面处轴的直径，mm；

[] τ T ——许用扭转切应力，MPa。

由于在连接轴端开了一个键槽，考虑到键槽对轴的削弱

作用，对于直径d ≤100 mm的轴，轴径增大 5%~7%。

3

25998 | 19.91 MPa<[ ]=25~45 MPa 0.2 (20 1.07)
τ | τ = | = × | ÷
T | T

扭转强度足够。

3. 轴的结构设计

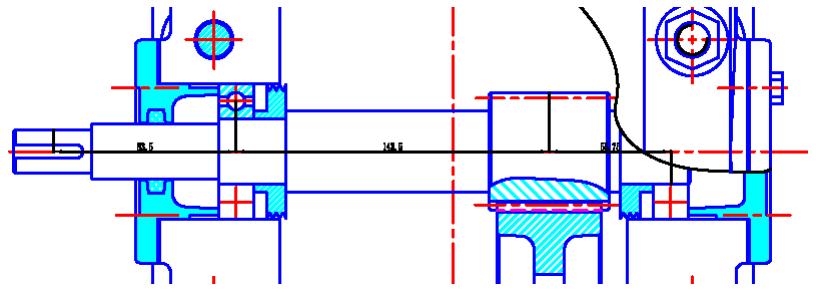
[picture p4: figure]

图 2 轴 I 结构图
各段直径从左往右依次是 20、25、30、35(决定于是否

是齿轮轴)、30 mm，这里需要注意的是这个图是考虑到制成

齿轮轴而修改过的图，如果齿轮与轴的配合段直径为 dg=35

mm，则需要开一个与键（10×8）相配的键槽，齿根圆到键

槽底部的距离

f1 | g | 2 ( | ) / 2 | (45.080 35) / 2 3.3
1.74 mm 2.5 | 5 mm

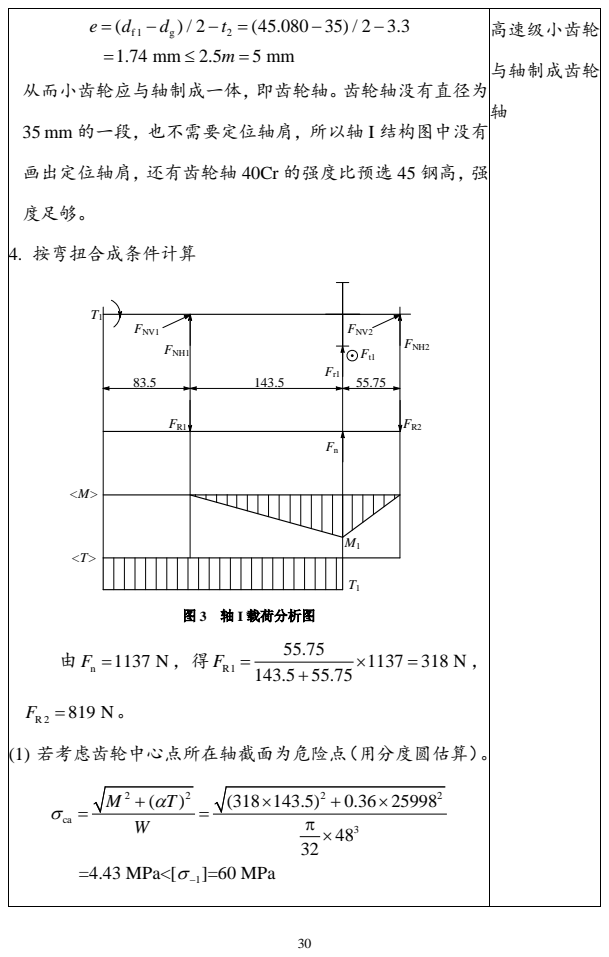
[picture p5: page 32]
度足够。; 4. 按弯扭合成条件计算; FNV2; FNV1; FNH1; FNH2; 图 3 轴 I 载荷分析图; (1) 若考虑齿轮中心点所在轴截面为危险点（用分度圆估算）。; =4.43 MPa<[ ]=60 MPa; 高速级小齿轮; 与轴制成齿轮

从而小齿轮应与轴制成一体，即齿轮轴。齿轮轴没有直径为

35 mm 的一段，也不需要定位轴肩，所以轴 I 结构图中没有

画出定位轴肩，还有齿轮轴 40Cr 的强度比预选 45 钢高，强

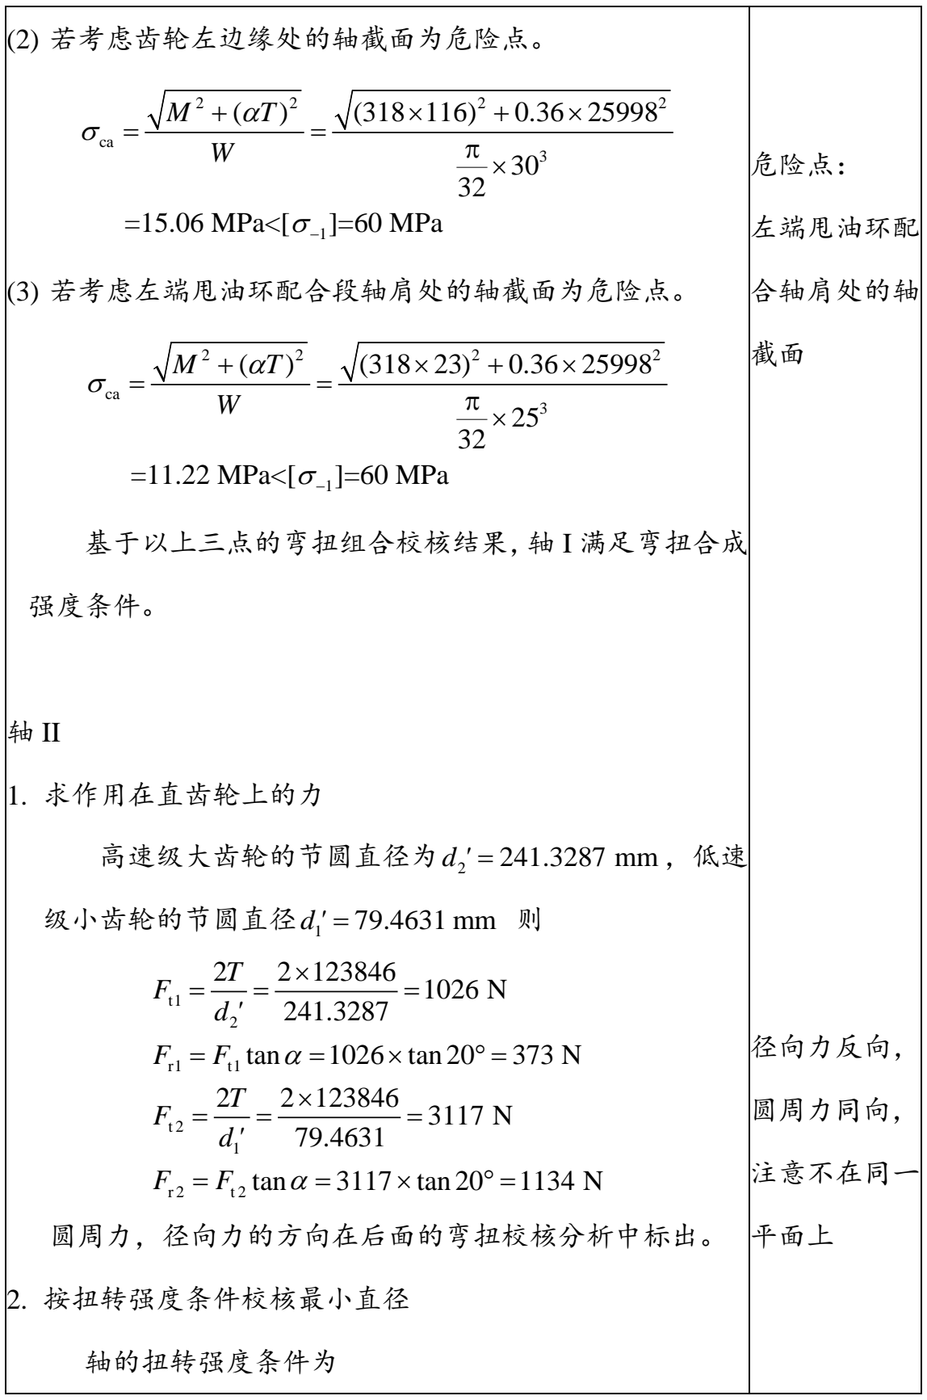
[picture p6: figure]
(2) 若考虑齿轮左边缘处的轴截面为危险点。; =15.06 MPa<[ ]=60 MPa; (3) 若考虑左端甩油环配合段轴肩处的轴截面为危险点。; =11.22 MPa<[ ]=60 MPa; 基于以上三点的弯扭组合校核结果，轴 I 满足弯扭合成; 强度条件。; 1. 求作用在直齿轮上的力; 高速级大齿轮的节圆直径为 2 d' = 241.3287 mm ，低速; 级小齿轮的节圆直径 1 d' = 79.4631 mm 则; tan; 1026 tan 20 373 N; 3117 tan 20 1134 N; 圆周力，径向力的方向在后面的弯扭校核分析中标出。; 2. 按扭转强度条件校核最小直径; 轴的扭转强度条件为; 危险点：; 左端甩油环配; 合轴肩处的轴; 径向力反向，; 圆周力同向，; 注意不在同一; 平面上

3 | [] 0.2
τ | τ T | T = | ≈ | ≤

T

T | T
W | d

式中：τ T ——扭转切应力，MPa；

T ——轴所受的扭矩，N∙mm；

WT ——轴的抗扭截面系数，mm³
；

d——计算截面处轴的直径，mm；

[] τ T ——许用扭转切应力，MPa。

材料选择 45 钢，调质处理，[ ] 25~45 MPa τ T = | 。

3 3

min
min

123846 30 mm
0.2[ ] | 0.2 25 τ = | = | =
T | ×

T d

3. 轴的结构设计

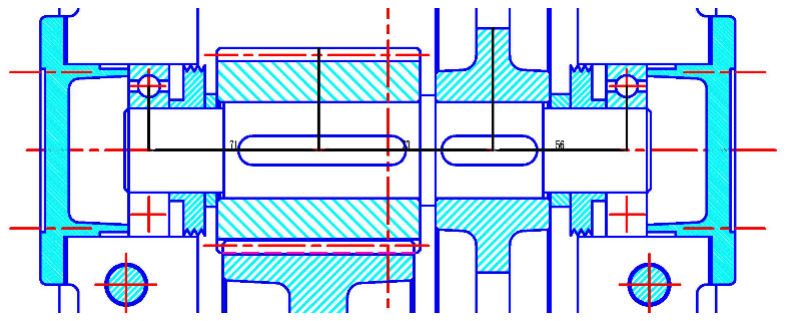
[picture p7: figure]

图 4 轴 II 结构图
各段直径从左往右依次是 35、40(决定于是否是齿轮

轴)、46、40、35 mm，可以看出如果低速级小齿轮齿轮与轴

的配合段直径为 dg=35 mm，则需要开一个与键（12×8）相

配的键槽，齿根圆到键槽底部的距离
f1 | g | 2 ( | ) / 2 | (74.250 40) / 2 3.3
13.825 mm>2.5 | 6.25 mm
= | − | −= | − | −
= | =
ed d | t
m

### min d = 30 mm

实际取

### min d = 35 mm

中间轴不需要

制成齿轮轴

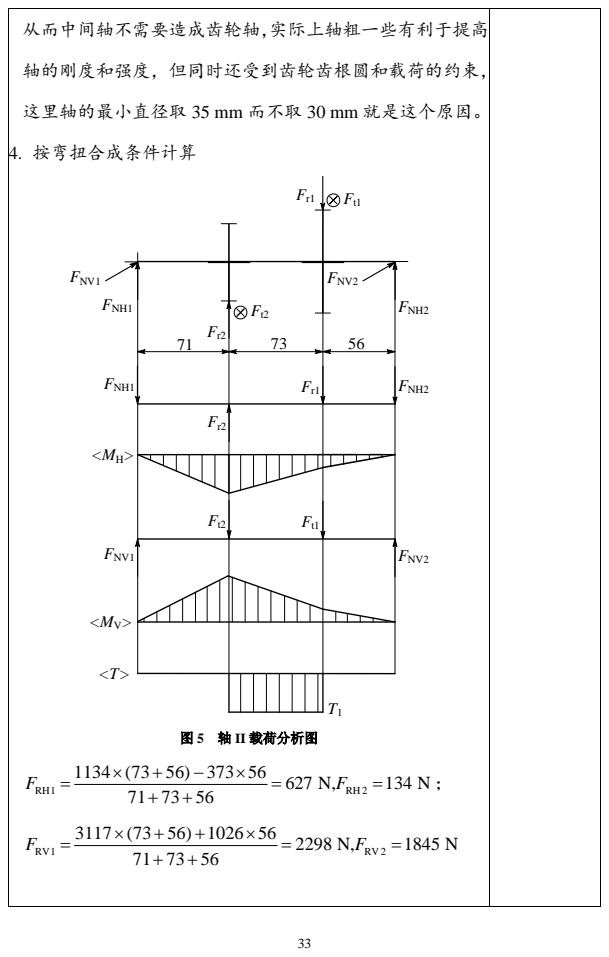
[picture p8: page 35]
从而中间轴不需要造成齿轮轴，实际上轴粗一些有利于提高; 轴的刚度和强度，但同时还受到齿轮齿根圆和载荷的约束，; 4. 按弯扭合成条件计算; FNV1; FNH1; FNH2; FNV2; 图 5 轴 II 载荷分析图

这里轴的最小直径取 35 mm 而不取 30 mm 就是这个原因。

考虑低速级小齿轮轮毂宽度中点所在的轴截面为危险

点，就足以判断整根轴的强度。

2 | 2
ca
2 | 2 | 2
| 3

1

()

(627 71) (2298 71) 0.36 123846 40
32

## =29.4 MPa<[ ]=60 MPa

α
σ

σ −

+ =

× | + | × | + | × = | π
×

M T
W

基于弯扭组合校核结果，轴 II 满足弯扭合成强度条件。

## 轴 III

1. 求作用在直齿轮上的力

低速级大齿轮的节圆直径 2 d' = 290.5369 mm 则

t1
2
r1 | t1
2 | 2 437481 3012 N
290.5369
tan | 3012 tan 20 1096 N α
× = | = | =
= | = | × | °=

T F
d'
FF

圆周力，径向力的方向在后面的弯扭校核分析中标出。

2. 按扭转强度条件校核最小直径

轴的扭转强度条件为

3 | [] 0.2
τ | τ T | T = | ≈ | ≤

T

T | T
W | d

式中：τ T ——扭转切应力，MPa；

T ——轴所受的扭矩，N∙mm；

WT ——轴的抗扭截面系数，mm³
；

d——计算截面处轴的直径，mm；

危险点：

低速级小齿轮

的轮毂宽度中

点所在轴截面

437481 45 mm
0.2[ ] | 0.2 25 τ = | = | =

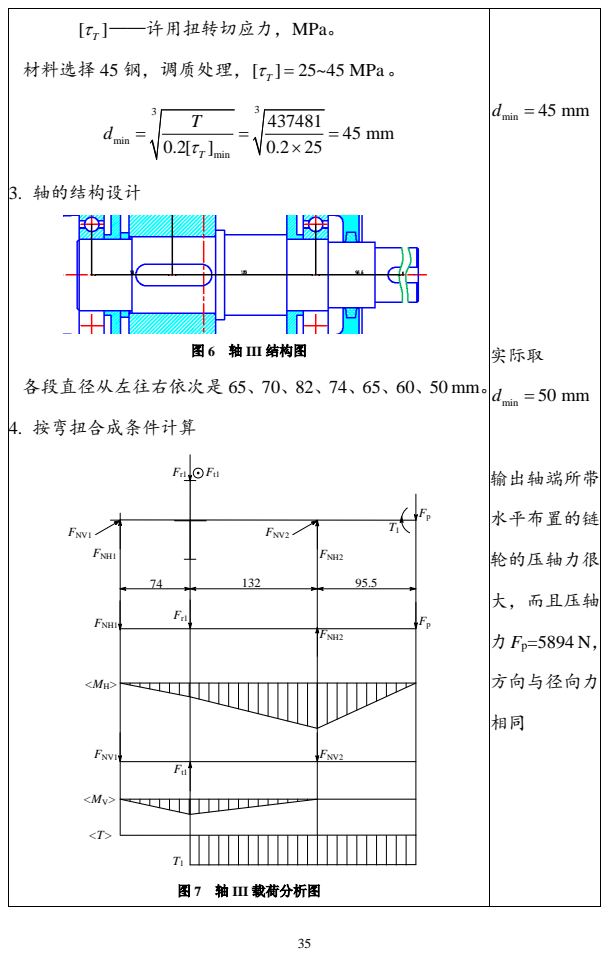
[picture p9: page 37]
[] τ T ——许用扭转切应力，MPa。; 材料选择 45 钢，调质处理，[ ] 25~45 MPa τ T =; min; 3. 轴的结构设计; 图 6 轴 III 结构图; 各段直径从左往右依次是 65、70、82、74、65、60、50 mm。; 4. 按弯扭合成条件计算; FNV1; FNH1; FNH2; FNV2; 图 7 轴 III 载荷分析图; min d = 45 mm; 实际取 min d = 50 mm; 输出轴端所带; 水平布置的链; 轮的压轴力很; 大，而且压轴; 力Fp=5894 N，; 方向与径向力

Fr1 FNH1

FNH2

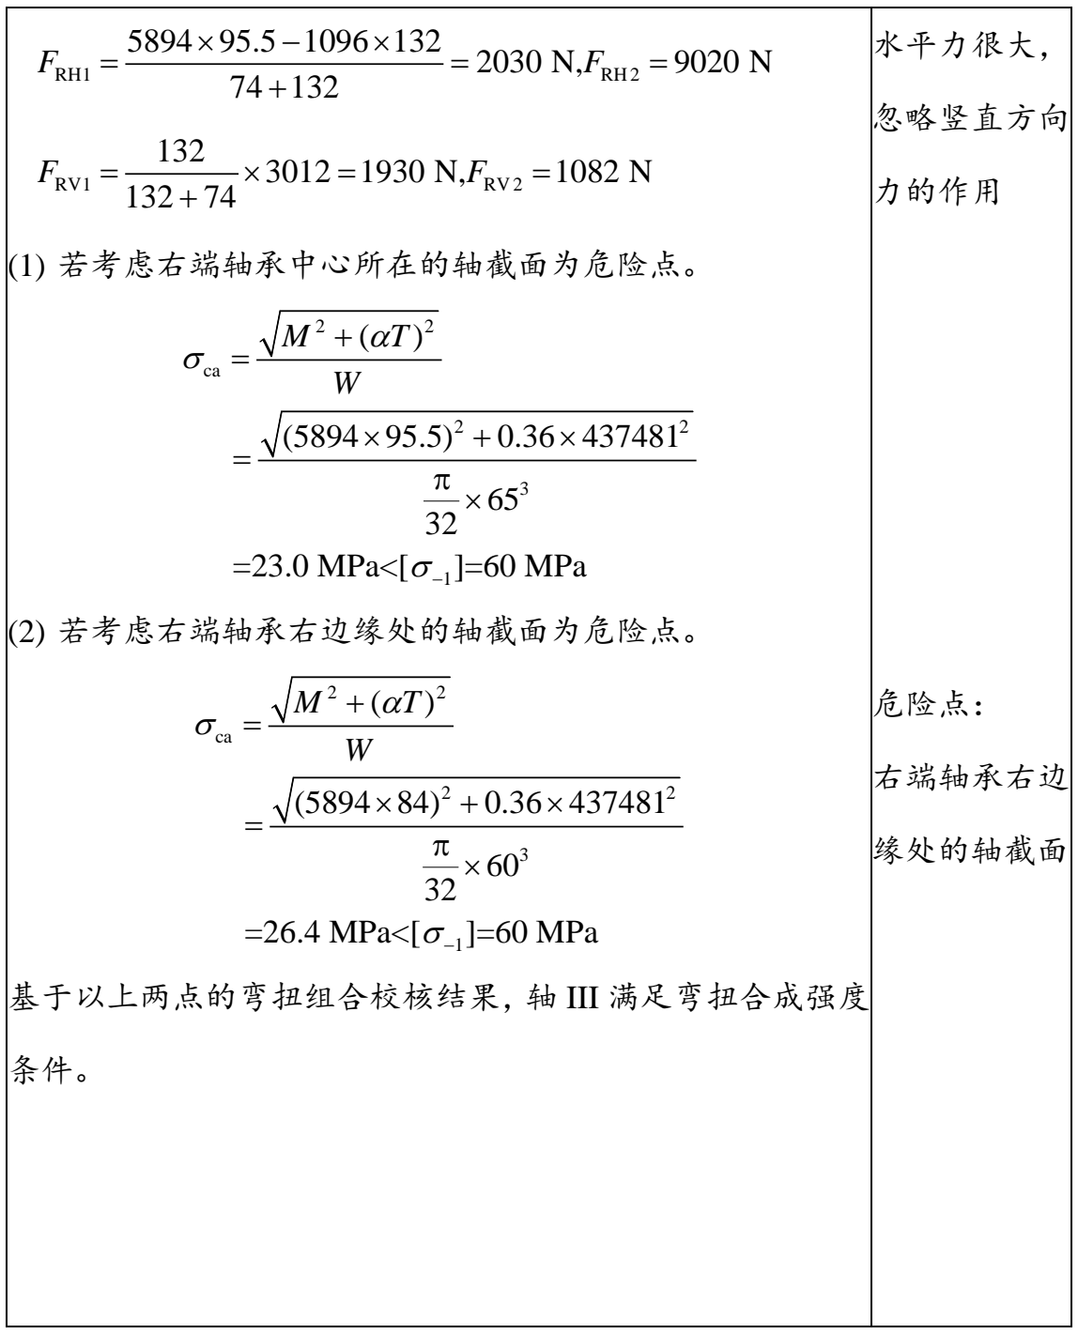
[picture p10: figure]
(1) 若考虑右端轴承中心所在的轴截面为危险点。; 32 =23.0 MPa<[ ]=60 MPa; (2) 若考虑右端轴承右边缘处的轴截面为危险点。; 32 =26.4 MPa<[ ]=60 MPa; 基于以上两点的弯扭组合校核结果，轴 III 满足弯扭合成强度; 水平力很大，; 忽略竖直方向; 力的作用; 危险点：; 右端轴承右边; 缘处的轴截面

5894 95.5 1096 132 2030 N, 9020 N 74 132

6. 键连接的设计计算

键连接的强度计算涉及到不同键、轴、轮毂的材料，取三者中最弱材料

的许用挤压应力，有轻微冲击时一般[σp]=100~200 MPa。

(1) 齿轮轴与联轴器之间的键连接

键 C bhl × ×= ×× 6 6 32，所在轴段直径d = 20 mm 。

p | p
4000 | 4000 25.998 | 29.89 MPa<[ ] 6 (32 0.5 6) 20
σ | σ
× = | = | = × | − | ××

T

### hld

(2) 中间轴与齿轮的连接

## 两个键，分别为键 A bhl × ×= ×× 12 8 40和键 A bhl × ×= ×× 12 8 70，

所在轴端直径均为 40 mm。校核较短的键

p | p
4000 | 4000 123.846 55.29 MPa<[ ] 8 (40 12) 40
σ | σ
× = | = | = × | − | ×

T

### hld

(3) 低速轴分别与齿轮和链轮的连接

## 两个，分别为键 A bhl × ×= × × 20 12 70和键 C bhl × ×= ×× 14 9 70，

所在轴端直径分别为 70 mm、50 mm。校核位于较细轴段且较窄的键

p | p
4000 | 4000 437.481 | 61.73 MPa<[ ] 9 (70 0.5 14) 50
σ | σ
× = | = | = × | − | × | ×

T

### hld

三个轴上的所有键连接都符合挤压强度条件。

7. 滚动轴承的设计计算

## (1) 轴 I 的轴承 6206

R1 | R 2 F | F = 0.318 kN, | 0.819 kN = | ，取载荷系数 fd=1.2，基本额定动载荷为

19.5 kN，轴承的寿命由受力较大的轴承决定。

3 6 10 | 19.5 | 18.8
300 2 8 60 1440 1.2 0.819
- | = | × | = | ××× × | × | t | 年

## (2) 轴 II 的轴承 6207

2 | 2 | 2 | 2
R1 | RH1 | RV1 F | F | F = | + | = | + 0.627 2.298 =2.382 kN
2 | 2 | 2 | 2
R 2 | RH 2 | RV 2 F | F | F = | + | = | + | = 1.845 0.134 1.850 kN

基本额定动载荷为 25.5 kN，轴承的寿命由受力较大的轴承决定。

3 6 10 | 25.5 | 8.4
300 2 8 60 293.28 1.2 2.382
- | = | × | = | ××× × | × | t | 年

## (3) 轴 III 的轴承 6213

2 | 2 | 2 | 2
R1 | RH1 | RV1 F | F | F = | + | = | + 2.030 1.930 =2.801 kN
2 | 2 | 2 | 2
R 2 | RH 2 | RV 2 F | F | F = | + | = | + | = 9.020 1.082 9.085 kN

基本额定动载荷为 57.2 kN，轴承的寿命由受力较大的轴承决定。

3 6 10 | 57.2 | 6.2
300 2 8 60 80.55 1.2 9.085
- | = | × | = | ××× × | × | t | 年

可以得出结论，三对轴承至少 6 年检修更换一次。

8. 箱体设计
(1) 铸铁减速箱的结构尺寸

箱座壁厚 δ=8 mm，箱盖壁厚 δ1=8 mm，地脚螺栓直径 df=20 mm，地脚

螺栓数目 4 个。具体尺寸见表 3。

表 3 铸铁减速箱结构尺寸表

名称符号 | 尺寸 | 名称符号 | 尺寸
箱座凸缘厚度 b | 12 | df、d1、d2 至凸缘边缘距离 c2 | 24、20、14
箱盖凸缘厚度 b1 | 12 | 轴承旁凸台半径 R1 | 20
箱座底凸缘厚度 b2 | 20 | 凸台高度 h | 55
轴承旁连接螺栓直径 d1 | 16 | 外箱壁至轴承座端面距离 l1 | 47
箱座与箱盖连接螺栓直径 d2 | 10 | 大齿轮顶圆与内箱壁距离 Δ1 | 8
连接螺栓 d2的间距 l | 150~200 | 齿轮端面与内箱壁距离 Δ2 | 8
轴承盖螺钉直径 d3 | 8 | 箱盖肋厚 m1 | 7
视孔盖螺钉直径 d4 | 8 | 箱座肋厚 m2 | 7
定位销直径 d | 8 | 轴承盖外径 D2 | 160、112、102
df、d1、d2 至外箱壁距离 c1 | 26、22、16 | 轴承旁连接螺栓距离 S | D2

## (2) 视孔盖

## A=180, A1=220, A2=200, B=105, B1=155, B2=130, R=10, h=5, Δ=5

## (3) 通气器

## 简易式通气器 M20×1.5, D=30, D1=25.4, S=22, L=28, l=15, a=4, d1=6

(4) 油尺

## d=M16, d1=4, d2=16, d3=6, h=35, a=12, b=8, c=5, D=26, D1=22

(5) 放油螺塞

## d=M16, D0=26, L=30, l=12, a=3, D=19.6, s=17, d1=17, H=2

## (6) 定位销

定位销 A8×40，数量 2 个

(7) 启盖螺钉

用全螺纹螺栓 M10×30 制成，端部做成半圆形，数量 1 个。

(8) 吊耳和吊钩

## d=b=20, R=24, e=20, H=24, h=12, r=6，吊耳 1 对，吊钩 2 对。

9. 润滑和密封设计

齿轮采用浸油润滑，两级大齿轮深度相当，所需油量为 6.9~7.6 升，

润滑油牌号 46。

轴承采用脂润滑，脂润滑易于密封，结构简单，维护方便。在箱体

轴承内一侧装设甩油环，防止油（齿轮润滑油）脂混合。润滑脂的填充

量为轴承室的 1/3~2/3，每隔半年或一年补充或更换一次。润滑脂牌号，

## 滚珠轴承润滑 SH 0386‑1992。

连接联轴器和链轮处的齿轮轴和低速轴需要在轴承盖处加毡圈密封，

毡圈磨损较大，一般也半年或一年更换一次。

放油螺塞和视孔盖都是要加石棉橡胶纸进行密封，不允许润滑油泄

露。

10.设计小结

通过这次课程设计，熟悉了机械设计的基本方法，并基本掌握了简

单的减速器设计过程。在这三周的时间里，一本新书被翻得比一般旧书

还旧，同时还要翻阅诸如机械制图、机械原理、公差测量等已学过的科

目教材和设计手册，说明机械设计每一个细节都是需要认真对待的。虽

然老师没有强调画图、计算、修改交替进行的做法，但我一直是这么做

的，比如轴承的选择，影响着轴的直径，发现轴的轴承寿命太短，则增

大轴径重新选择轴承，或者空间允许的话，换用宽系列的轴承。在设计

中，出现预算错误或忽略某个给定的尺寸时，对最后的结果可能不会有

影响，但是机械设计过程的许多工作是反复的，如果到最后都没有发现

自己某一步的失误，

11.参考文献

[1] 濮贵良, 陈国定, 吴立言. 机械设计[M]. 9 版. 北京 :高等教育出版社, 2013
[2] 李育锡. 机械设计课程设计[M]. 2 版. 北京 :高等教育出版社, 2014
[3] 孙桓, 陈作模, 葛文杰. 机械原理[M]. 8 版. 北京 :高等教育出版社, 2013.
[4] 苟文选. 材料力学(I) [M]. 2 版. 北京 :科学出版社, 2010
[5] 臧宏琦, 等. 机械制图[M]. 4 版. 西安 :西北工业大学出版社, 2012
[6] 刘笃喜, 王玉. 机械精度设计与检测技术[M]. 2 版. 北京 :国防工业出版社, 2012
