e71828/Spur-gear-reducer/传动简图.pdf

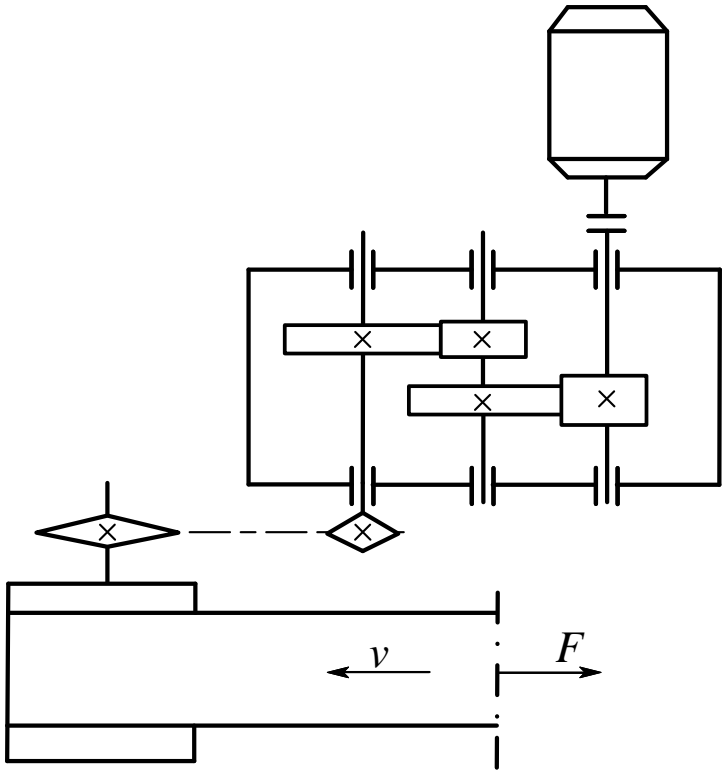
[picture p11: figure]
