e71828/Spur-gear-reducer/(list of files, cad)

Other CAD files:
装配图A0.dwg
轴_A3.dwg
直齿轮A3.dwg
箱盖A1.dwg
